furdozy/WILD/site/images/phillips.JPG

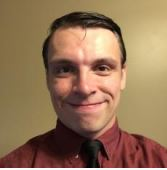
site/images/phillips.JPG
