furdozy/WILD/site/images/adventure-clouds-daylight-1145375.jpg

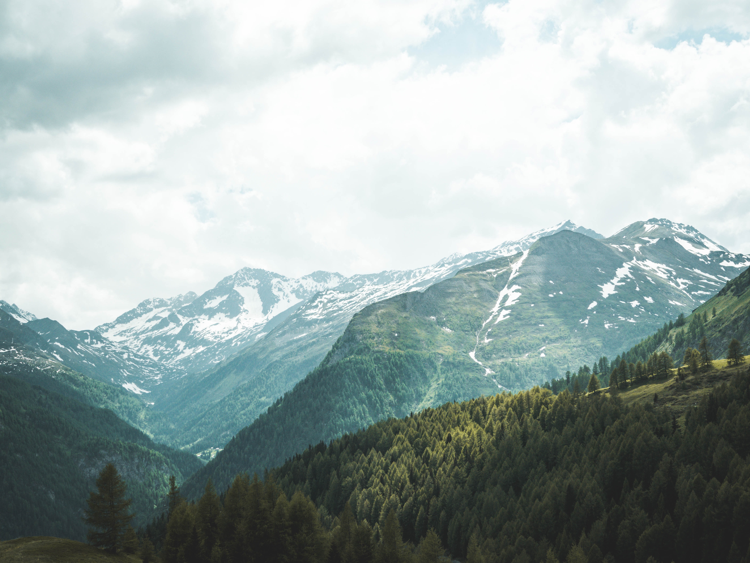
site/images/adventure-clouds-daylight-1145375.jpg
