furdozy/WILD/site/images/sedlack.jpg

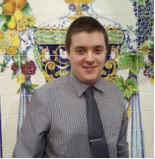
site/images/sedlack.jpg
