furdozy/WILD/site/images/tuggle.jpg

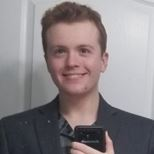
site/images/tuggle.jpg
