furdozy/WILD/Energia/WILD/pages.h

#define  VIEW  "                    <  View Messages   >                                        "
  //row         <     row 0        ><     row 1        ><     row 2        ><     row 3        >              
#define SEND   "                    <   Send Message   >                                        "
  //row         <     row 0        ><     row 1        ><     row 2        ><     row 3        >                    
#define OPT    "                    <     Options      >                                        "
  //row         <     row 0        ><     row 1        ><     row 2        ><     row 3        >                   
#define SOS    "                    <    Send  SOS     >                                        "
  //row         <     row 0        ><     row 1        ><     row 2        ><     row 3        >                   
#define INFO   "Wilderness Info     Device              Designed by UCF SD  Group 10 Summer 2019"
  //row         <     row 0        ><     row 1        ><     row 2        ><     row 3        >
#define ADD    "Select a device to  add:                <     blank        >                    "
  //row         <     row 0        ><     row 1        ><     row 2        ><     row 3        >
#define EXIT   "                           Exit                                                 "
