furdozy/WILD/Energia/WILD/custChars.h

uint8_t topRight[8] = {
  0b11111,
  0b10111,
  0b11111,
  0b00011,
  0b00001,
  0b00001,
  0b11001,
  0b11101
};

uint8_t topMiddle[8]= {
  0b11111,
  0b10001,
  0b00011,
  0b00111,
  0b01110,
  0b01100,
  0b10000,
  0b10000
};
uint8_t topLeft[8]={
  0b11111,
  0b11111,
  0b11110,
  0b11110,
  0b11101,
  0b11101,
  0b11001,
  0b11011
};
uint8_t bottomRight[8]={
  0b00111,
  0b00011,
  0b01001,
  0b01101,
  0b11001,
  0b11011,
  0b11111,
  0b11111
};
uint8_t bottomMiddle[8]={
  0b10000,
  0b01100,
  0b00011,
  0b11001,
  0b00110,
  0b00001,
  0b11111,
  0b11111
};
uint8_t bottomLeft[8]={
  0b11010,
  0b11001,
  0b11101,
  0b11100,
  0b11110,
  0b11111,
  0b11111,
  0b11111
};
uint8_t black[8]={
  0b11111,
  0b11111,
  0b11111,
  0b11111,
  0b11111,
  0b11111,
  0b11111,
  0b11111
};
uint8_t white[8]={
  0b0,
  0b0,
  0b0,
  0b0,
  0b0,
  0b0,
  0b0,
  0b0
};
