furdozy/WILD/Energia/demos/WILD/message.h

#include "node.h"
#include "Energia.h"
//Function to send a message. To send a broadcast message, call with dest=0xffff. 
int send(String msg,int dest){
  
  //open serial communication
//  Serial.begin(9600);
  
  //enter command mode
//  Serial.write("+++");
//  delay 50;//delay to ensure the commands are reccognized

//  String setDest="AT 
//Serial.write(
}
