furdozy/WILD/(commit log)

2019-07-10 Add files via upload
    contains several documents that will not be used on final iteration. they serve as placeholder documents for the current state of the site
2019-07-15 Function read_keyboard reads keyboard input
    Also contains check_message and send_message function. Created only for testing purposes. As you can see in check_message, in order to check if then enter/return key was pressed, the column and row pin states will need to be set and read. Since the current iteration of the keyboard breakout board is worn, row4 cannot be read from properly; however, row4 is where enter will be checked.
2019-07-23 update lcd pin definitions as spec'd by main board
2019-07-23 Added Code Description
    This program prints 4 lines to the LCD from memory on startup, then takes in keyboard input until the enter key is pressed. After, the program writes the input text to memory. Disconnect power and plug back in to display the values saved to memory.
2019-07-25 Revert "Storage Changes"
    This reverts commit 6d9712e0ce98863ba31405fe4ddd20b350dfc69c.
    [storage.cpp, ui.cpp]
2019-07-25 current things
2019-07-26 Potential Fix for UI and Storage
    [storage.cpp, ui.cpp]
